husham-eng/flex-glove-sign/results/paper/fig_cm_T1.png

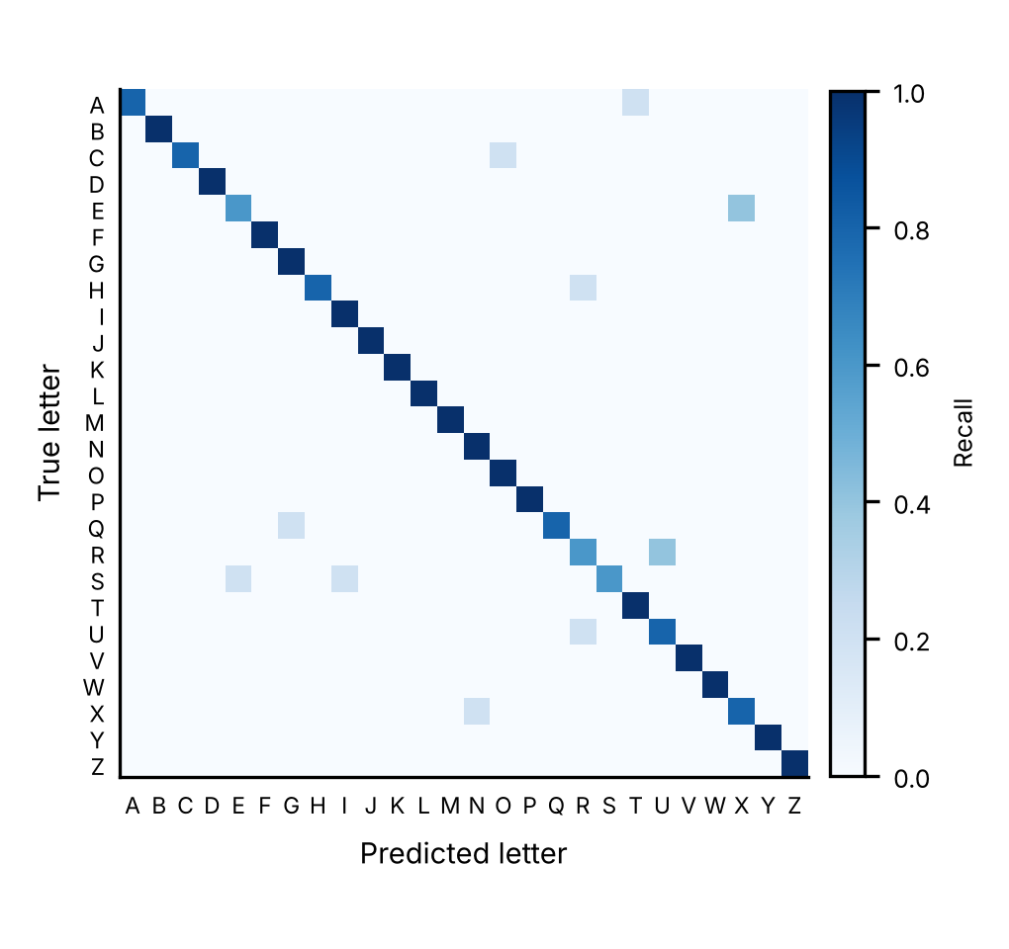
results/paper/fig_cm_T1.png
