husham-eng/flex-glove-sign/results/paper/fig_faults.png

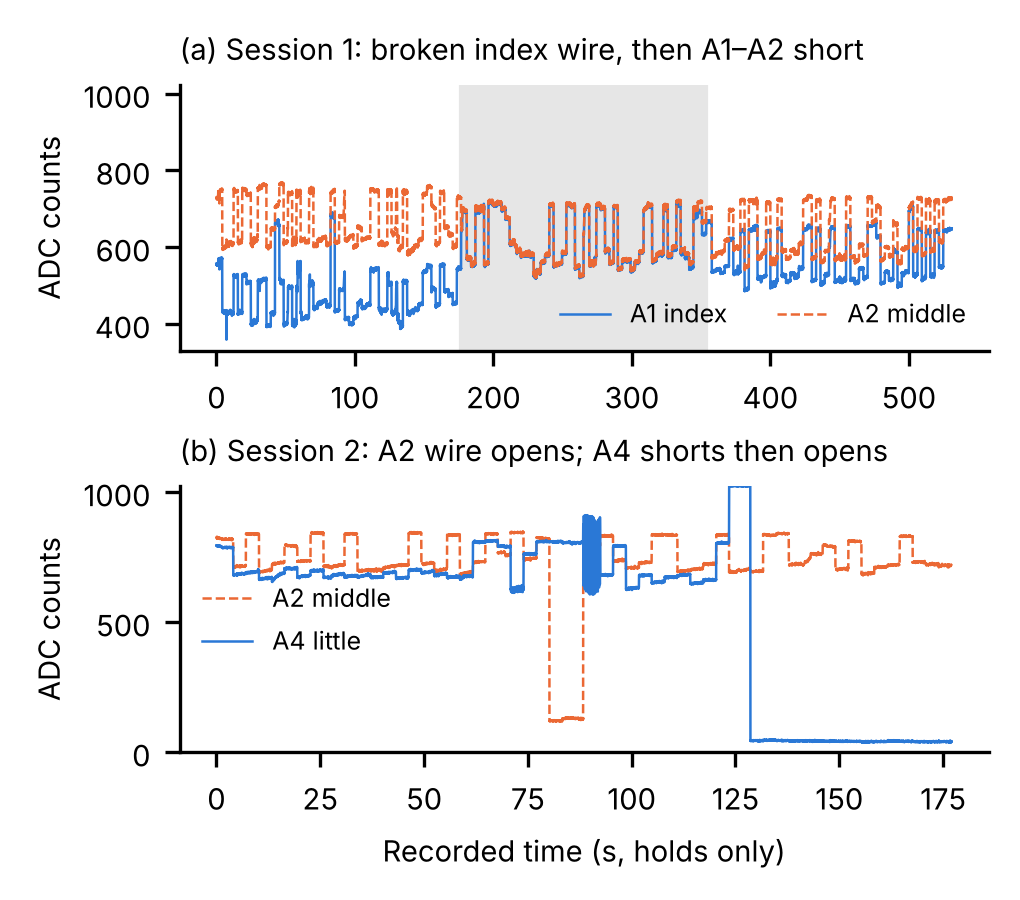
results/paper/fig_faults.png
