husham-eng/flex-glove-sign/results/paper/fig_fingerprint.png

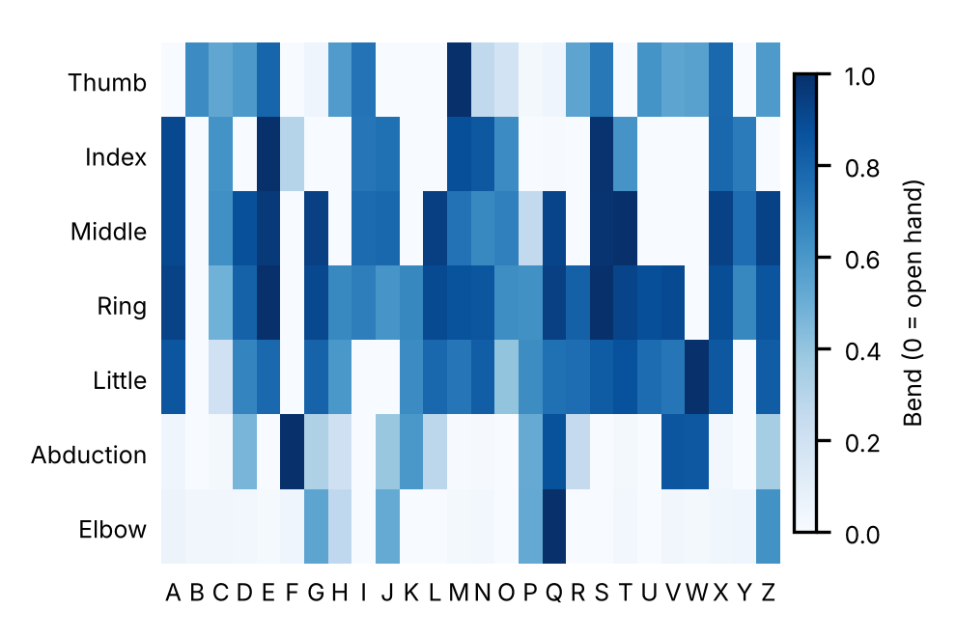
results/paper/fig_fingerprint.png
