husham-eng/flex-glove-sign/results/paper/fig_learning_curve.png

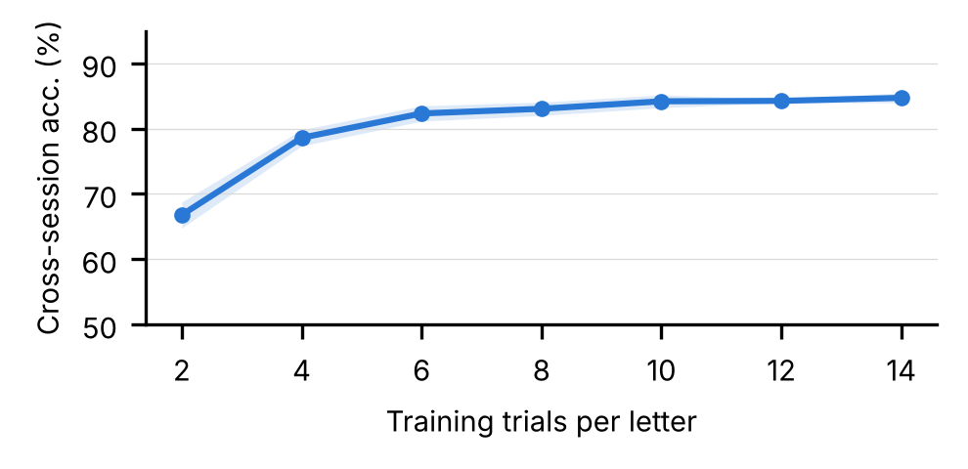
results/paper/fig_learning_curve.png
