husham-eng/flex-glove-sign/data/characterisation/bend_test_A5A6_insulated.csv

channel | phase | t_ms | f0 | f1 | f2 | f3 | f4 | f5 | f6
5 | relax | 9880 | 738 | 560 | 821 | 840 | 805 | 774 | 792
5 | relax | 9860 | 742 | 565 | 821 | 840 | 804 | 775 | 792
5 | relax | 9880 | 738 | 560 | 821 | 840 | 805 | 774 | 792
5 | relax | 9860 | 742 | 565 | 821 | 840 | 804 | 775 | 792
5 | relax | 9880 | 738 | 560 | 821 | 840 | 805 | 774 | 792
5 | relax | 9900 | 739 | 562 | 820 | 840 | 806 | 774 | 790
5 | relax | 9920 | 740 | 561 | 819 | 841 | 805 | 770 | 787
5 | relax | 9940 | 739 | 561 | 823 | 841 | 804 | 773 | 793
5 | relax | 9960 | 738 | 564 | 821 | 840 | 804 | 774 | 789
5 | relax | 9980 | 737 | 561 | 824 | 842 | 805 | 774 | 791
5 | relax | 10000 | 739 | 561 | 820 | 841 | 804 | 775 | 789
5 | relax | 10020 | 739 | 561 | 822 | 842 | 804 | 772 | 788
5 | relax | 10040 | 739 | 562 | 824 | 842 | 805 | 775 | 791
5 | relax | 10060 | 741 | 562 | 823 | 842 | 802 | 776 | 793
5 | relax | 10080 | 738 | 565 | 821 | 840 | 804 | 774 | 792
5 | relax | 10100 | 738 | 562 | 823 | 843 | 803 | 773 | 789
5 | relax | 10120 | 739 | 562 | 823 | 840 | 803 | 772 | 787
5 | relax | 10140 | 738 | 562 | 825 | 841 | 805 | 775 | 793
5 | relax | 10160 | 737 | 562 | 823 | 843 | 806 | 773 | 793
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
