husham-eng/flex-glove-sign/data/characterisation/bend_test_after_A5A6_reversal.csv

channel | phase | t_ms | f0 | f1 | f2 | f3 | f4 | f5 | f6
0 | relax | 6720 | 832 | 828 | 821 | 824 | 780 | 786 | 787
0 | relax | 6740 | 832 | 829 | 819 | 826 | 779 | 791 | 805
0 | relax | 6760 | 834 | 829 | 817 | 825 | 781 | 793 | 809
0 | relax | 6780 | 833 | 829 | 817 | 826 | 784 | 791 | 805
0 | relax | 6800 | 832 | 829 | 820 | 824 | 781 | 790 | 803
0 | relax | 6820 | 830 | 828 | 817 | 826 | 781 | 784 | 790
0 | relax | 6840 | 831 | 827 | 817 | 826 | 780 | 787 | 801
0 | relax | 6860 | 830 | 830 | 820 | 826 | 780 | 792 | 813
0 | relax | 6880 | 830 | 829 | 820 | 824 | 782 | 790 | 806
0 | relax | 6900 | 833 | 829 | 818 | 825 | 779 | 790 | 801
0 | relax | 6920 | 829 | 827 | 818 | 824 | 777 | 785 | 791
0 | relax | 6940 | 830 | 826 | 819 | 824 | 781 | 790 | 802
0 | relax | 6960 | 833 | 833 | 820 | 827 | 782 | 793 | 810
0 | relax | 6980 | 832 | 829 | 815 | 824 | 781 | 789 | 805
0 | relax | 7000 | 830 | 827 | 818 | 826 | 783 | 790 | 802
0 | relax | 7020 | 834 | 825 | 820 | 823 | 778 | 784 | 790
0 | relax | 7040 | 832 | 827 | 819 | 825 | 778 | 786 | 799
0 | relax | 7060 | 833 | 834 | 819 | 823 | 782 | 794 | 811
0 | relax | 7080 | 832 | 827 | 817 | 826 | 782 | 791 | 805
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
