husham-eng/flex-glove-sign/data/characterisation/bend_test_after_index_repair.csv

channel | phase | t_ms | f0 | f1 | f2 | f3 | f4 | f5 | f6
0 | relax | 12100 | 817 | 814 | 808 | 828 | 786 | 751 | 780
0 | relax | 12120 | 816 | 815 | 808 | 827 | 784 | 755 | 782
0 | relax | 12100 | 817 | 814 | 808 | 828 | 786 | 751 | 780
0 | relax | 12120 | 816 | 815 | 808 | 827 | 784 | 755 | 782
0 | relax | 12140 | 816 | 814 | 809 | 825 | 782 | 752 | 780
0 | relax | 12160 | 816 | 814 | 805 | 826 | 783 | 751 | 778
0 | relax | 12180 | 814 | 813 | 807 | 826 | 781 | 748 | 778
0 | relax | 12200 | 818 | 815 | 808 | 827 | 783 | 753 | 783
0 | relax | 12220 | 815 | 815 | 808 | 824 | 782 | 752 | 783
0 | relax | 12240 | 817 | 814 | 810 | 824 | 783 | 753 | 783
0 | relax | 12260 | 818 | 816 | 809 | 825 | 780 | 751 | 779
0 | relax | 12280 | 816 | 815 | 809 | 825 | 781 | 751 | 779
0 | relax | 12300 | 817 | 814 | 807 | 826 | 782 | 755 | 783
0 | relax | 12320 | 818 | 815 | 809 | 825 | 784 | 755 | 780
0 | relax | 12340 | 815 | 817 | 809 | 826 | 784 | 753 | 780
0 | relax | 12360 | 815 | 815 | 809 | 825 | 782 | 750 | 778
0 | relax | 12380 | 815 | 815 | 806 | 827 | 780 | 748 | 779
0 | relax | 12400 | 816 | 815 | 811 | 824 | 784 | 752 | 783
0 | relax | 12420 | 815 | 813 | 807 | 826 | 784 | 751 | 780
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
