husham-eng/flex-glove-sign/data/characterisation/bend_test_v2.csv

channel | phase | t_ms | f0 | f1 | f2 | f3 | f4 | f5 | f6
0 | relax | 12620 | 833 | 825 | 819 | 819 | 777 | 792 | 807
0 | relax | 12640 | 831 | 826 | 814 | 817 | 776 | 790 | 806
0 | relax | 12620 | 833 | 825 | 819 | 819 | 777 | 792 | 807
0 | relax | 12640 | 831 | 826 | 814 | 817 | 776 | 790 | 806
0 | relax | 12620 | 833 | 825 | 819 | 819 | 777 | 792 | 807
0 | relax | 12640 | 831 | 826 | 814 | 817 | 776 | 790 | 806
0 | relax | 12660 | 832 | 824 | 812 | 816 | 777 | 785 | 796
0 | relax | 12680 | 832 | 824 | 813 | 817 | 777 | 790 | 804
0 | relax | 12700 | 831 | 829 | 816 | 817 | 777 | 791 | 810
0 | relax | 12720 | 832 | 826 | 816 | 815 | 777 | 792 | 808
0 | relax | 12740 | 831 | 827 | 815 | 818 | 779 | 789 | 805
0 | relax | 12760 | 831 | 824 | 816 | 816 | 773 | 786 | 799
0 | relax | 12780 | 832 | 825 | 814 | 817 | 778 | 791 | 806
0 | relax | 12800 | 833 | 827 | 815 | 816 | 781 | 795 | 812
0 | relax | 12820 | 829 | 825 | 812 | 815 | 779 | 791 | 807
0 | relax | 12840 | 832 | 825 | 815 | 814 | 777 | 789 | 802
0 | relax | 12860 | 831 | 827 | 814 | 814 | 776 | 785 | 797
0 | relax | 12880 | 832 | 826 | 815 | 817 | 777 | 789 | 808
0 | relax | 12900 | 832 | 826 | 816 | 817 | 778 | 792 | 812
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
