husham-eng/flex-glove-sign/data/characterisation/little_finger_wiggle.csv

channel | phase | t_ms | f0 | f1 | f2 | f3 | f4 | f5 | f6
4 | relax | 8700 | 822 | 818 | 821 | 825 | 790 | 760 | 790
4 | relax | 8720 | 823 | 817 | 820 | 826 | 790 | 762 | 790
4 | relax | 8700 | 822 | 818 | 821 | 825 | 790 | 760 | 790
4 | relax | 8720 | 823 | 817 | 820 | 826 | 790 | 762 | 790
4 | relax | 8740 | 820 | 817 | 820 | 826 | 787 | 759 | 787
4 | relax | 8760 | 818 | 817 | 819 | 826 | 790 | 761 | 788
4 | relax | 8780 | 822 | 819 | 822 | 828 | 787 | 762 | 792
4 | relax | 8800 | 822 | 819 | 820 | 827 | 790 | 760 | 790
4 | relax | 8820 | 824 | 818 | 819 | 826 | 790 | 761 | 793
4 | relax | 8840 | 822 | 818 | 820 | 827 | 789 | 763 | 788
4 | relax | 8860 | 820 | 818 | 820 | 825 | 787 | 761 | 788
4 | relax | 8880 | 822 | 819 | 820 | 827 | 790 | 763 | 790
4 | relax | 8900 | 820 | 817 | 821 | 827 | 786 | 760 | 790
4 | relax | 8920 | 821 | 818 | 821 | 826 | 789 | 762 | 791
4 | relax | 8940 | 823 | 817 | 819 | 825 | 788 | 759 | 787
4 | relax | 8960 | 821 | 818 | 818 | 825 | 790 | 761 | 788
4 | relax | 8980 | 820 | 818 | 820 | 827 | 790 | 763 | 794
4 | relax | 9000 | 823 | 817 | 819 | 826 | 789 | 762 | 791
4 | relax | 9020 | 823 | 817 | 819 | 827 | 790 | 761 | 790
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
