husham-eng/flex-glove-sign/(commit log)

2026-11-09 Seven-sensor flex glove: firmware, data collection, analysis and ML benchmark
    - Arduino Mega firmware: 5 finger flex sensors, index-middle abduction sensor,
    elbow sensor, optional MPU-6050, 50 Hz CSV over USB
    - Guided data collection for all 26 ASL letters with per-trial correct-letter review
    - Analysis reproducing the paper tables on real data (drift, 2x2 ablation, IMU,
    learning curve, added-sensor effect, per-trial table, latency)
    - Benchmark of 23 ML and deep models with statistical tests and nested tuning
    - Live demo, circuit schematic, citation metadata
    Claude-Session: https://claude.ai/code/session_01Bow15GRePqnAw9tXRhBdb8
    [analyze.py, collect_data.py, features.py, flex_glove_logger.ino, live_demo.py, ml_benchmark.py]
2026-11-10 Add sensor characterisation script; single author; fix 7-sensor texts
    - python/sensor_characterisation.py: bench test of one flex sensor
    (hysteresis, repeatability, noise, sensitivity, R_flex range, figure)
    - Authors: Othman Alfahad only (.zenodo.json, CITATION.cff, README)
    - data/README.md: columns f0..f6 and characterisation folder
    - analyze.py / ml_benchmark.py: feature count no longer hard-coded as 30
    - README: characterisation + power measurement step, J/Z window limitation
    Claude-Session: https://claude.ai/code/session_01Bow15DH9qEnKoG2obKsRCr
    [analyze.py, ml_benchmark.py, sensor_characterisation.py]
2026-11-10 Use random letter order for training participants too; fix study sizes
    5 training participants x 3 sessions x 10 rounds, 3 test participants x
    1 session x 5 rounds, random order in every round for both groups.
    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
    [collect_data.py, train_test.py]
2026-11-10 Add guided bend test for the seven channels
    Prompts relax/bend for each channel, saves data/characterisation/bend_test.csv
    and prints straight/bent ADC, crosstalk, R_flex and the best fixed resistor.
    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
    [bend_test.py]
2026-11-10 Double the data-collection timings (ready 3 s, hold 3 s, J/Z 5 s, rest 4 s)
    Participants found 1.5 s too short to form each letter.
    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
    [collect_data.py]
2026-11-10 Drop stale serial-buffer samples at the start of each recording
    In --manual mode the first line of a hold could be a sample left in the OS
    buffer from before the participant pressed Enter (seen in the pilot as a
    100-400 s timestamp gap). Removed at recording time and in resample_window.
    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
2026-11-10 Optional median despike filter (off by default: it lowered accuracy on S1)
    features.despike() with MEDIAN_K; applied in build_trials and live_demo so
    training and live use the same preprocessing.
    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
2026-11-10 Automatic glove quality check after every round (quality.py)
    Detects rail values, shorted channels, contact spikes, broken/slipped
    sensors (REST out of range or shifted) and non-responding fingers. Run
    inside collect_data.py after each round, or standalone on a saved CSV.
    Validated on S1 session 1: flags the A1-A2 short (rounds 3-4), the A4
    spikes (rounds 1-3) and the broken index wire; silent on a healthy glove.
    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
    [collect_data.py, quality.py]
2026-11-10 Resume an interrupted session (--resume) and discard faulty rounds (quality.py --discard)
    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
2026-11-11 Discard typed-ahead key presses before each prompt
    A double or held Enter answered the next letter prompt and skipped letters
    (seen in S1 session 3, round 6).
    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
    [collect_data.py]
2026-11-11 Deposit recorded data, add paper_results.py and reproduced paper tables/figures
    - data/: main sessions S1-2..4 and T1, sensitivity session S1-1, pilot, sensor bench tests
    - python/paper_results.py regenerates Tables II-V and Figs. 3-6 into results/paper/
    - README, data README, .zenodo.json and CITATION.cff updated (author Dr. Othman Alfahd)
    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
    [PILOT_sess1.csv, PILOT_sess1_trials.csv, S1_sess1.csv, S1_sess1_trials.csv, S1_sess2.csv, S1_sess2_trials.csv, S1_sess3.csv, S1_sess3_trials.csv]
2026-11-11 Describe tendon-driven abduction sensor; add prototype photo
    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
